artandtechspace/Smart-Arrow/Arrows stl data/Stütze Kanal v1.stl

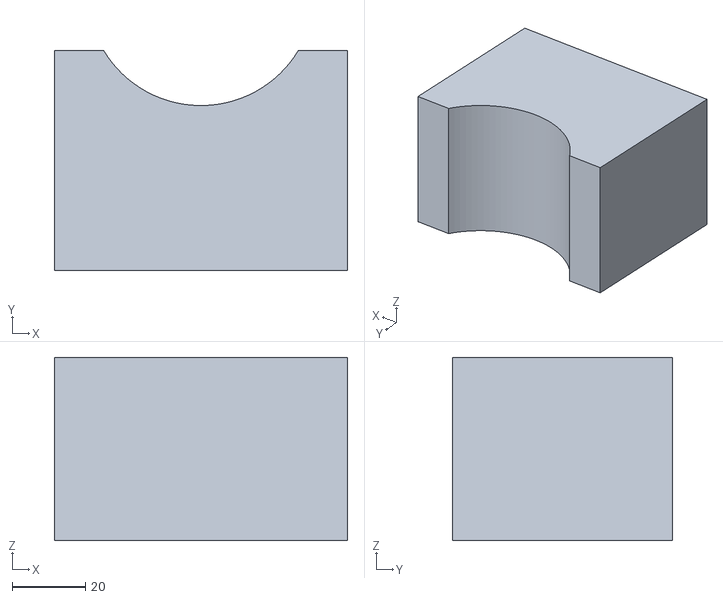
[picture p3: CAD file, 2025-03-22]
Arrows stl data/Stütze Kanal v1.stl
80.0 x 60.0 x 50.0
