artandtechspace/Smart-Arrow/Arrows stl data/Pfeilbauteil mit Wand v2.stl

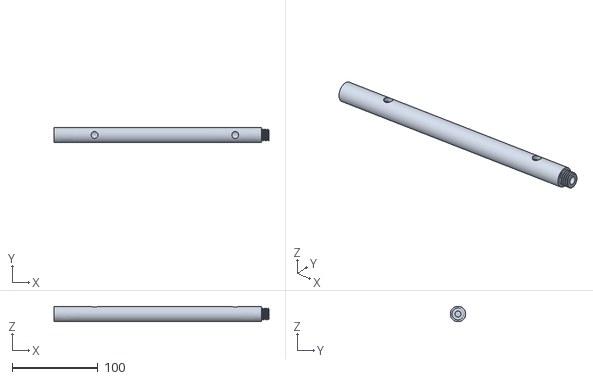
[picture p4: CAD file, 2025-03-22]
Arrows stl data/Pfeilbauteil mit Wand v2.stl
250.0 x 18.0 x 18.0
