artandtechspace/Smart-Arrow/Arrows stl data/Pfeilspitzenhalter v13.stl

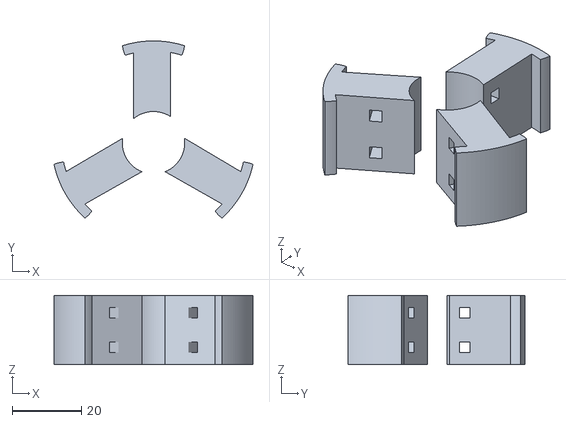
[picture p5: CAD file, 2025-03-22]
Arrows stl data/Pfeilspitzenhalter v13.stl
57.4 x 51.1 x 20.0
