artandtechspace/Smart-Arrow/Arrows stl data/Gewinde.stl

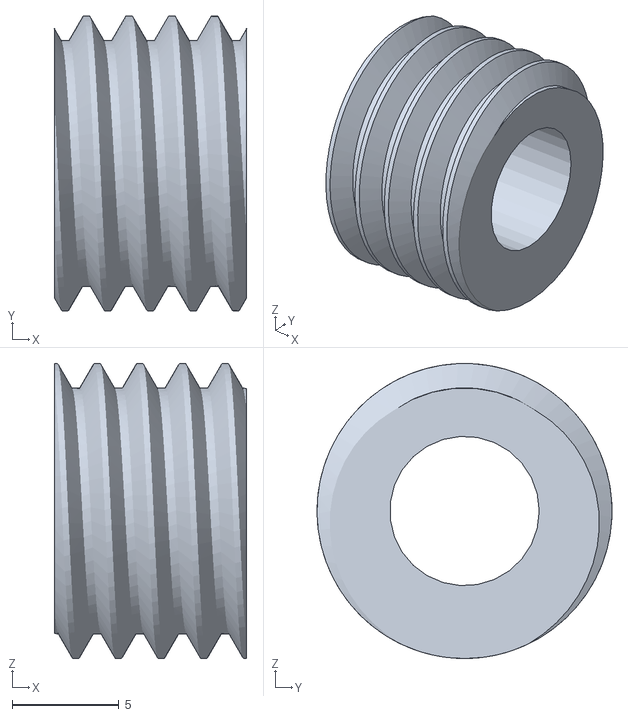
[picture p6: CAD file, 2025-03-06]
Arrows stl data/Gewinde.stl
9.00 x 13.8 x 13.8
