artandtechspace/Smart-Arrow/Arrows stl data/Pfeilspitze 13 mm v7.stl

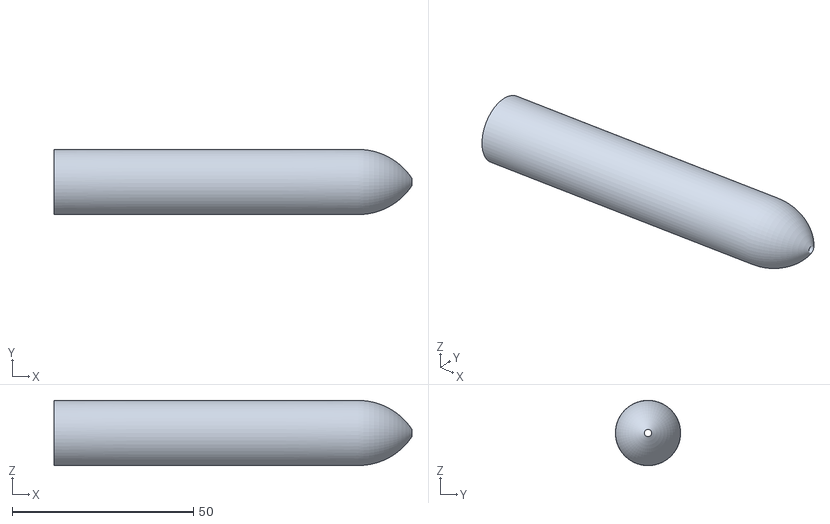
[picture p7: CAD file, 2025-03-06]
Arrows stl data/Pfeilspitze 13 mm v7.stl
98.8 x 18.0 x 18.0
