artandtechspace/Smart-Arrow/Arrows stl data/Pfeilbauteil Querschnitt.stl

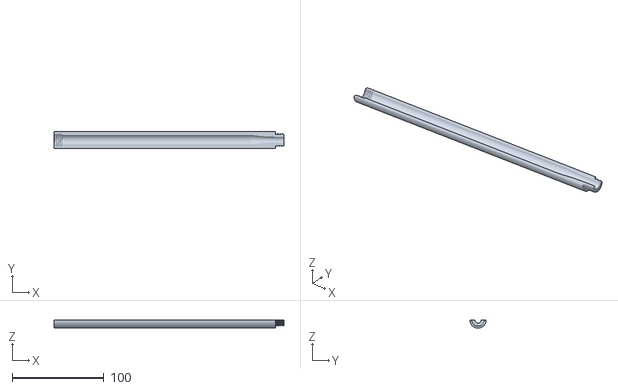
[picture p8: CAD file, 2025-03-06]
Arrows stl data/Pfeilbauteil Querschnitt.stl
250.0 x 18.0 x 9.00
