artandtechspace/Smart-Arrow/Arrows stl data/Pfeilspitzenhalter v12.stl

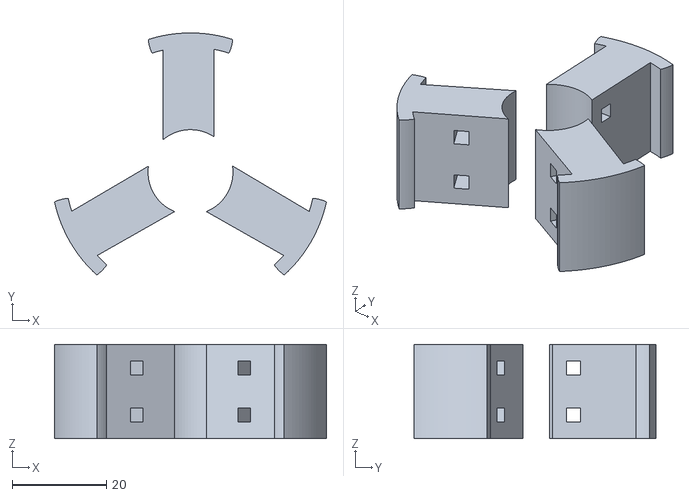
[picture p9: CAD file, 2025-03-22, an earlier design]
Arrows stl data/Pfeilspitzenhalter v12.stl
57.6 x 51.3 x 20.0
