artandtechspace/Smart-Arrow/Arrows stl data/Pfeilbauteil mit Wand v1.stl

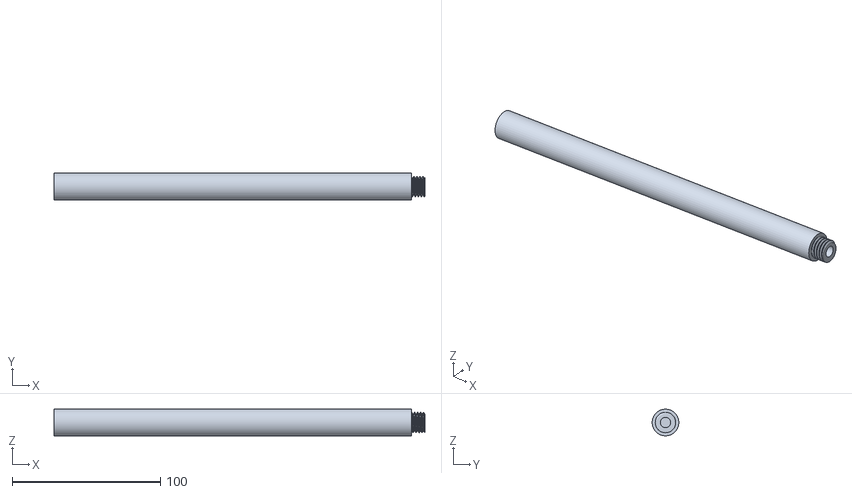
[picture p10: CAD file, 2025-03-22, an earlier design]
Arrows stl data/Pfeilbauteil mit Wand v1.stl
250.0 x 18.0 x 17.9
