artandtechspace/Smart-Arrow/Arrows stl data/Pfeilspitze 13 mm v1.stl

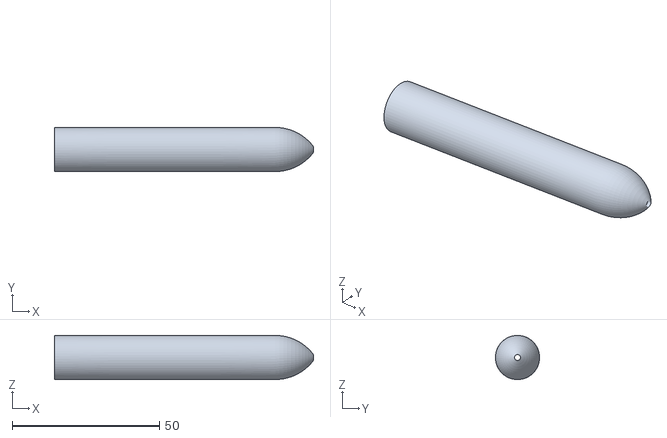
[picture p11: CAD file, 2025-03-06, an earlier design]
Arrows stl data/Pfeilspitze 13 mm v1.stl
88.0 x 15.0 x 15.0
