artandtechspace/Smart-Arrow/Arrows stl data/Pfeilbauteil v1.stl

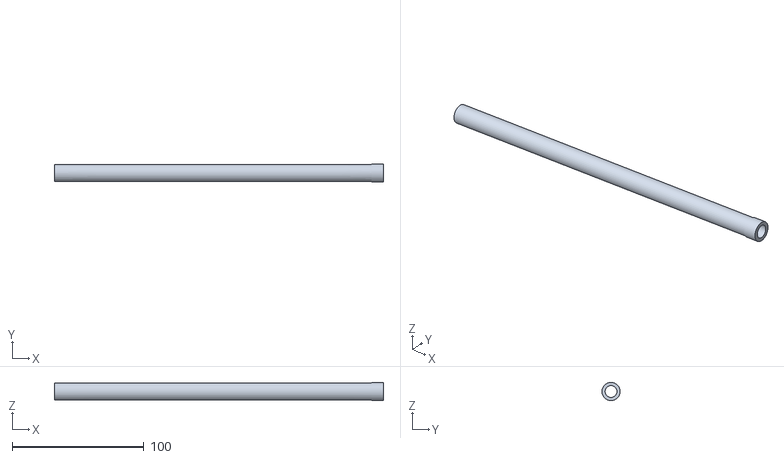
[picture p12: CAD file, 2025-03-06, an earlier design]
Arrows stl data/Pfeilbauteil v1.stl
250.0 x 13.8 x 13.8
