artandtechspace/Smart-Arrow/Arrows stl data/Pfeilspitze 13 mm v6.stl

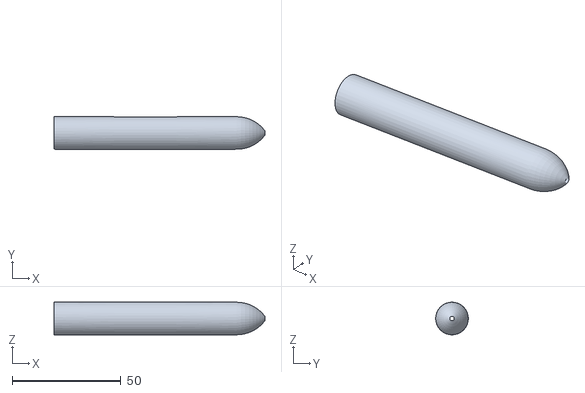
[picture p13: CAD file, 2025-03-06, an earlier design]
Arrows stl data/Pfeilspitze 13 mm v6.stl
97.0 x 15.0 x 15.0
