artandtechspace/Smart-Arrow/Arrows stl data/Pfeilspitzenhalter v2.stl

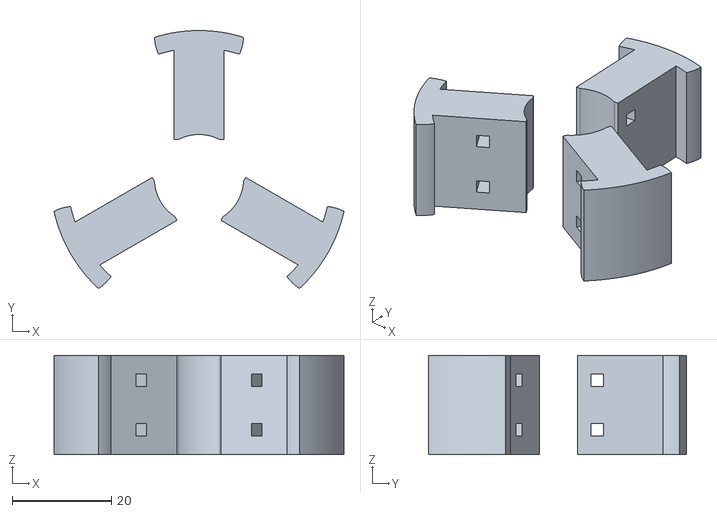
[picture p14: CAD file, 2025-03-06, an earlier design]
Arrows stl data/Pfeilspitzenhalter v2.stl
58.6 x 52.1 x 20.0
