artandtechspace/Smart-Arrow/Arrows stl data/Pfeilspitzenhalter v1.stl

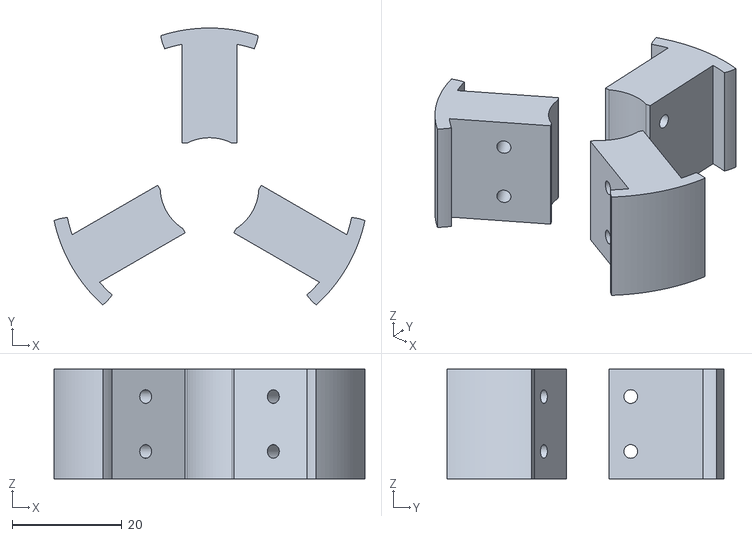
[picture p15: CAD file, 2025-03-06, an earlier design]
Arrows stl data/Pfeilspitzenhalter v1.stl
56.7 x 50.5 x 20.0
