artandtechspace/Smart-Arrow/Arrows stl data/Pfeilspitzenhalter v9.stl

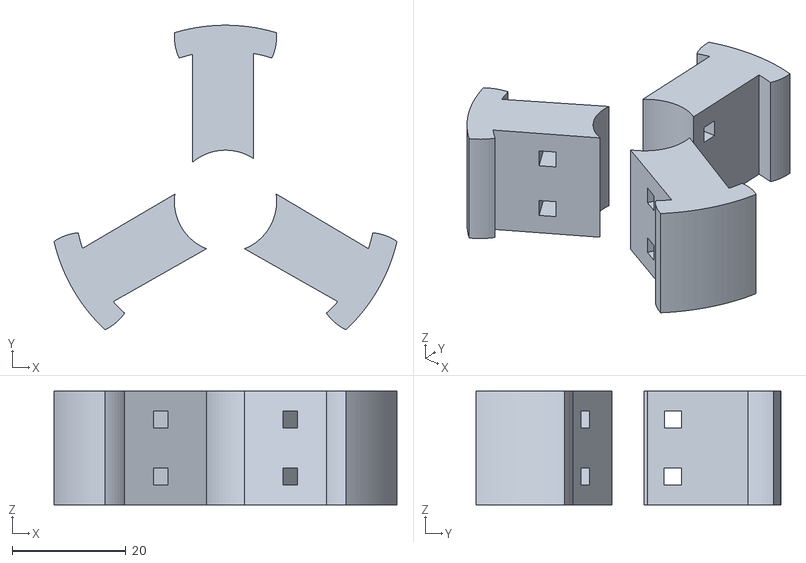
[picture p16: CAD file, 2025-03-06, an earlier design]
Arrows stl data/Pfeilspitzenhalter v9.stl
60.4 x 53.6 x 20.0
