artandtechspace/Smart-Arrow/Arrows stl data/Pfeilspitze 13 mm v3.stl

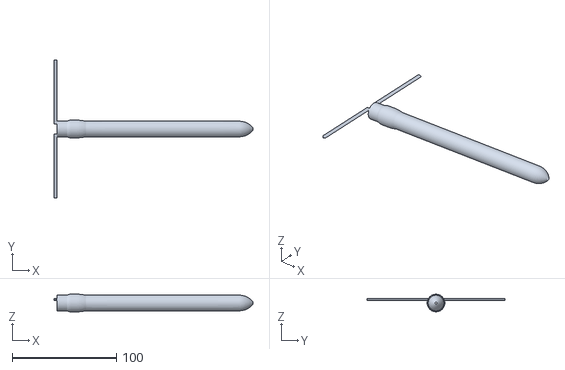
[picture p17: CAD file, 2025-03-06, an earlier design]
Arrows stl data/Pfeilspitze 13 mm v3.stl
191.0 x 132.0 x 17.0
