artandtechspace/Smart-Arrow/Arrows stl data/Pfeilspitzenhalter v10.stl

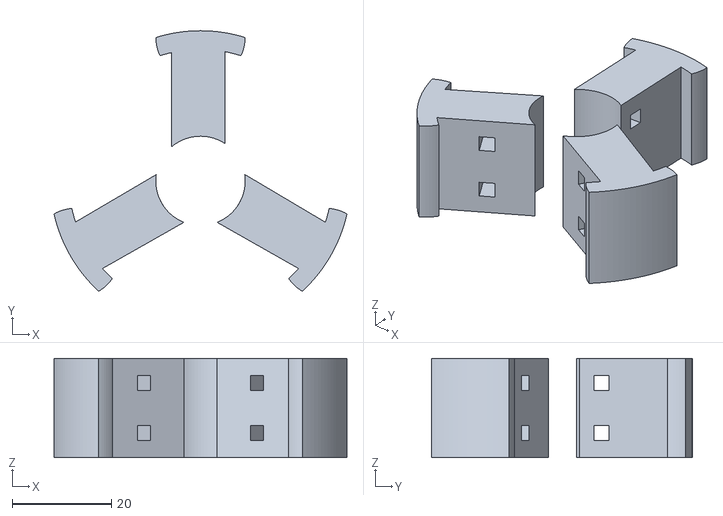
[picture p18: CAD file, 2025-03-06, an earlier design]
Arrows stl data/Pfeilspitzenhalter v10.stl
59.0 x 52.5 x 20.0
