artandtechspace/Smart-Arrow/(list of files, cad)

Other CAD files:
Arrows stl data/Pfeilbauteil v5.stl
Arrows stl data/Pfeilbauteil v4.stl
Arrows stl data/Pfeilbauteil v2.stl
Arrows stl data/Pfeilbauteil v3.stl
Arrows stl data/Pfeilspitze 13 mm v2.stl
Arrows stl data/Pfeilspitze 13 mm v5.stl
Arrows stl data/Pfeilspitzenhalter v11.stl
Arrows stl data/Pfeilspitzenhalter v3.stl
Arrows stl data/Pfeilspitzenhalter v4.stl
Arrows stl data/Pfeilspitzenhalter v5.stl
Arrows stl data/Pfeilspitzenhalter v7.stl
Arrows stl data/Pfeilspitzenhalter v8.stl
