artandtechspace/Smart-Arrow/Hardware/Pfeil.kicad_pcb

## KiCad design Hardware/Pfeil.kicad_pcb (2025-03-22)

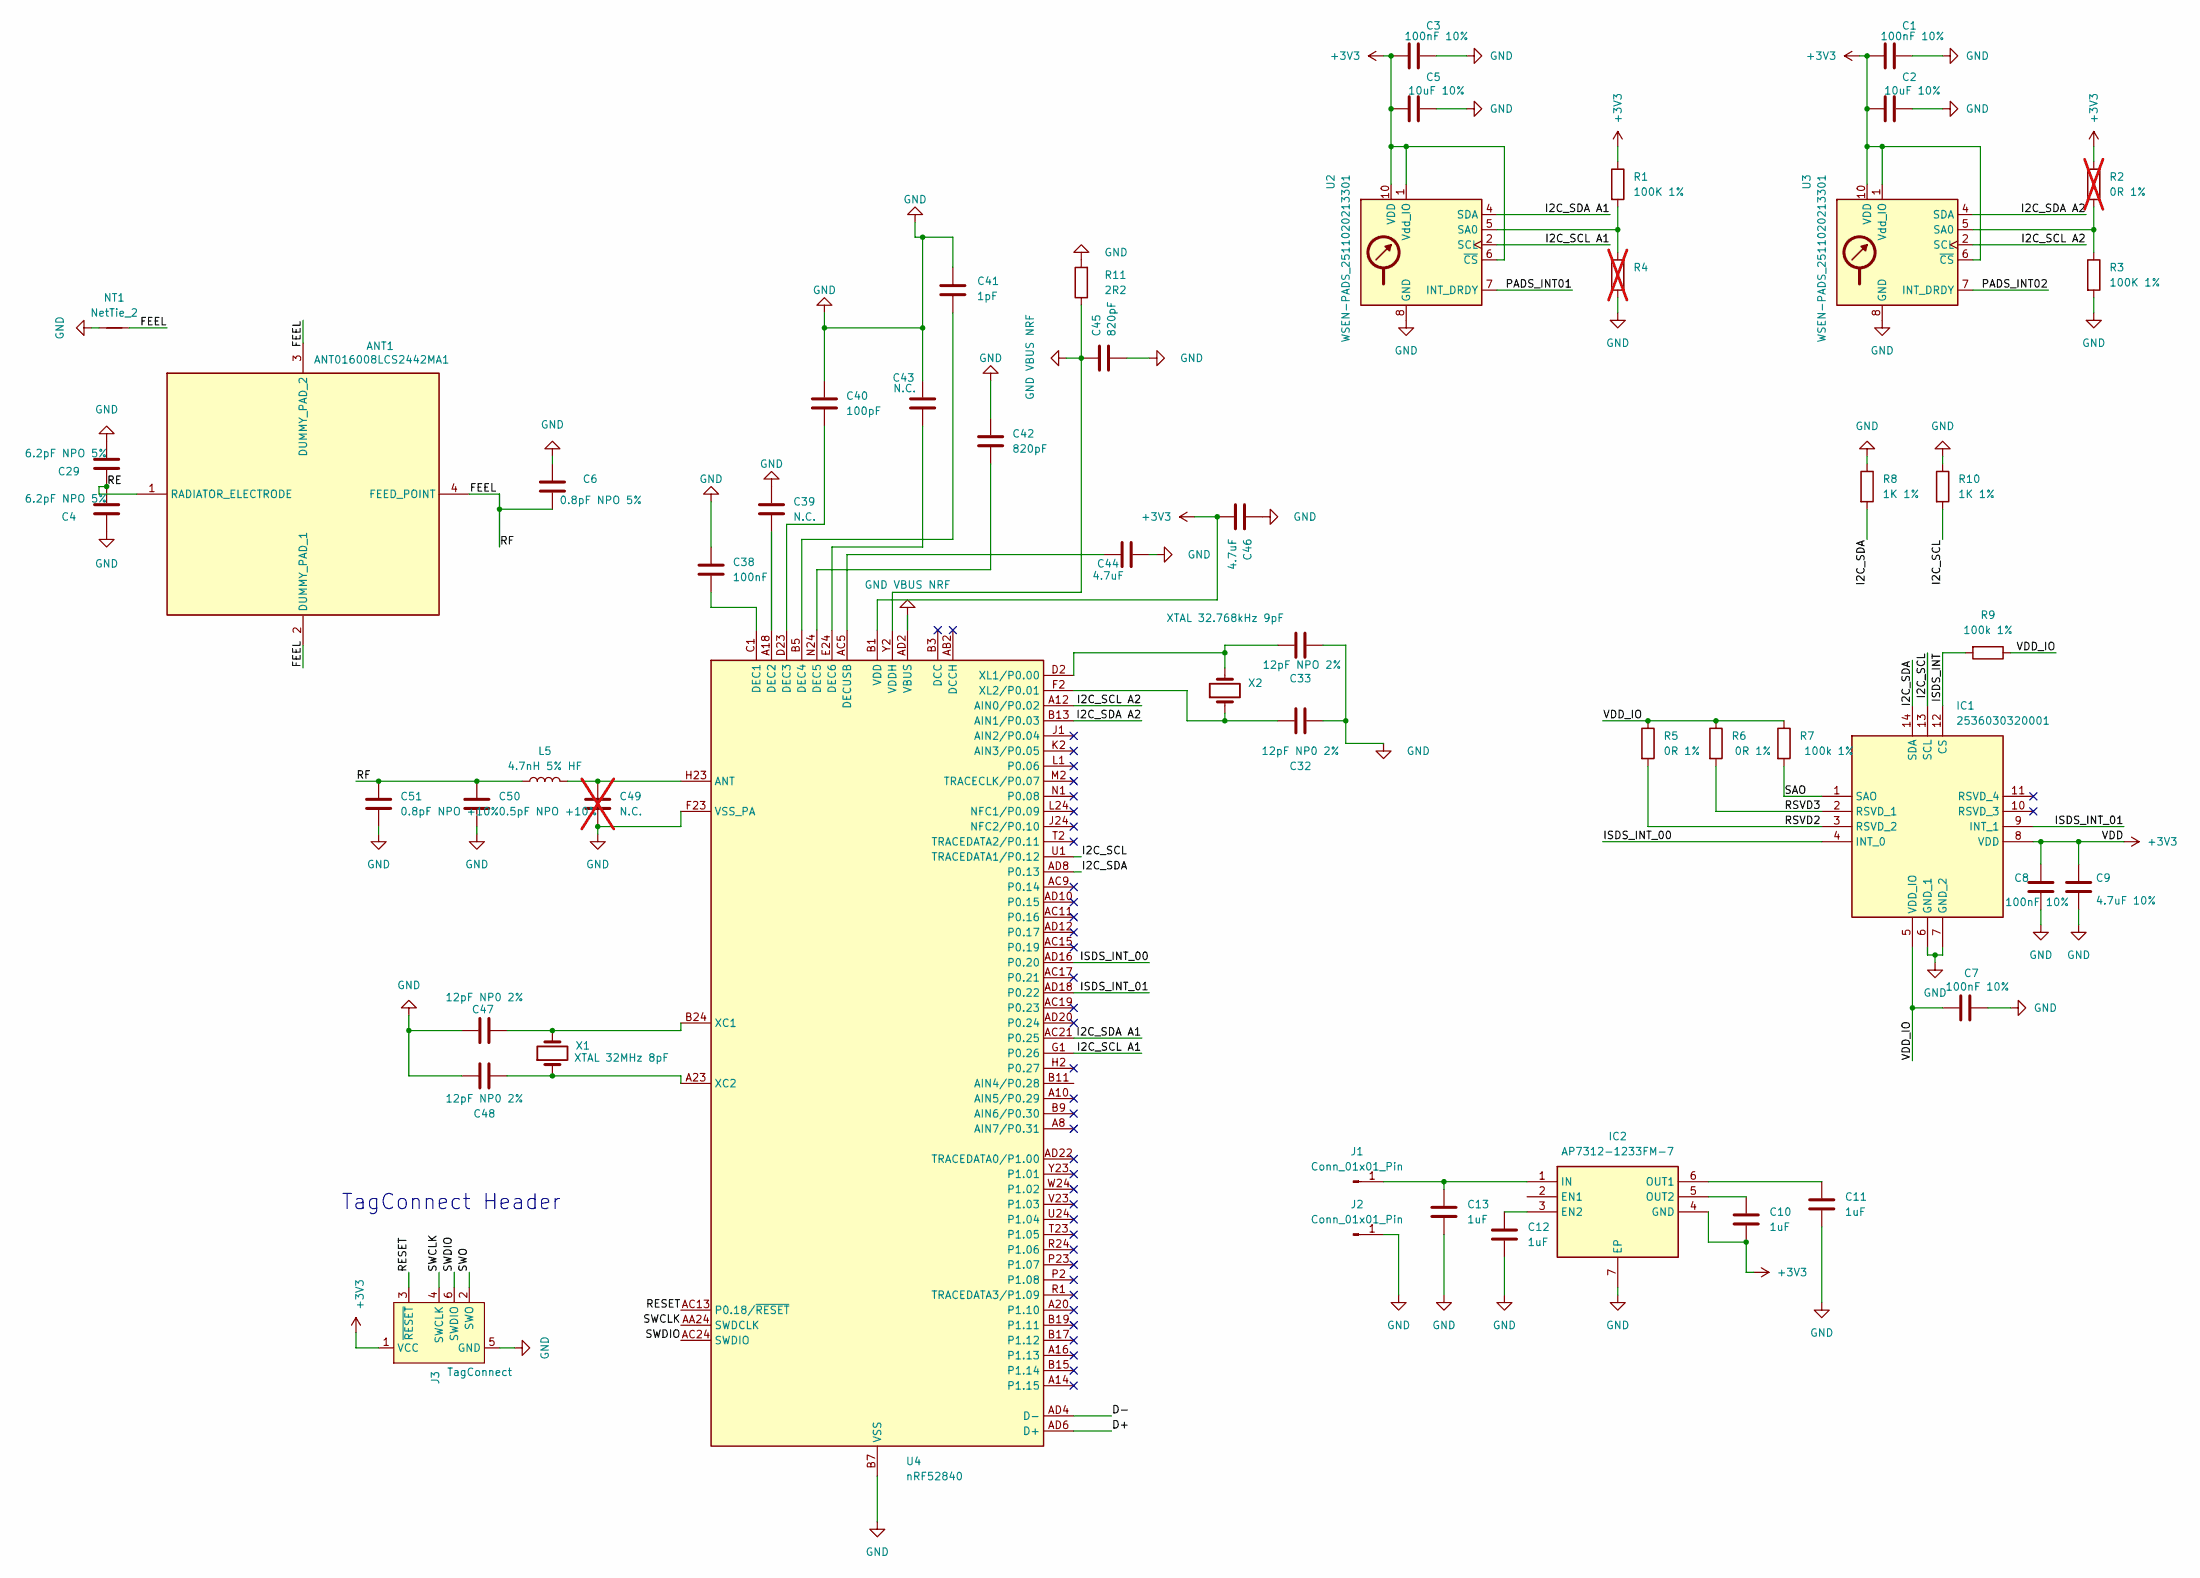
[picture p19: schematic Pfeil.kicad_sch]

Parts:
ANT1: ANT016008LCS2442MA1; Mouser Part Number 810-ANT168LCS2442MA1
C1, C3, C7, C8: 100nF 10%; C_0201_0603Metric
C2, C5: 10uF 10%; C_0402_1005Metric
C4, C29: 6.2pF NPO 5%; C_0201_0603Metric
C6: 0.8pF NPO 5%; C_0201_0603Metric
C9: 4.7uF 10%; C_0201_0603Metric
C10, C11, C12, C13: 1uF; C_0805_2012Metric
C32, C47, C48: 12pF NP0 2%; C_0201_0603Metric
C33: 12pF NPO 2%; C_0201_0603Metric
C38: 100nF; C_0201_0603Metric
C39, C43: N.C.; C_0201_0603Metric
C40: 100pF; C_0201_0603Metric
C41: 1pF; C_0201_0603Metric
C42, C45: 820pF; C_0201_0603Metric
C44, C46: 4.7uF; C_0201_0603Metric
C49: N.C.; C_0201_0603Metric; not fitted
C50: 0.5pF NPO +10%; C_0201_0603Metric
C51: 0.8pF NPO +10%; C_0201_0603Metric
IC1: 2536030320001; Mouser Part Number 710-2536030320001
IC2: AP7312-1233FM-7; SON50P201X181X60-7N; Mouser Part Number 621-AP7312-1233FM-7
J1, J2: Conn_01x01_Pin; SolderWirePad_1x01_SMD_1x2mm
J3: TagConnect; Tag-Connect_TC2030-IDC-NL_2x03_P1.27mm_Vertical
L5: 4.7nH 5% HF; LED_0402_1005Metric
NT1: NetTie_2; NetTie-2_SMD_Pad0.5mm
R1, R3: 100K 1%; R_0201_0603Metric
R2: 0R 1%; R_0201_0603Metric; not fitted
R4: R_0201_0603Metric; not fitted
R5, R6: 0R 1%; R_0201_0603Metric
R7, R9: 100k 1%; R_0201_0603Metric
R8, R10: 1K 1%; R_0201_0603Metric
R11: 2R2; R_0201_0603Metric
U2, U3: WSEN-PADS_2511020213301; ST_HLGA-10_2x2mm_P0.5mm_LayoutBorder3x2y
U4: nRF52840; Nordic_AQFN-73-1EP_7x7mm_P0.5mm
X1: XTAL 32MHz 8pF; Crystal_SMD_2016-4Pin_2.0x1.6mm
X2: XTAL 32.768kHz 9pF; Crystal_SMD_2016-4Pin_2.0x1.6mm

Connections:
+3V3: C1.1, C2.1, C3.1, C5.1, C8.1, C9.1, C10.2, C46.2, IC1.8 (VDD), IC2.4 (GND), J3.1 (VCC), R1.1, R2.1, U2.1 (Vdd_IO), U2.6 (~CS), U2.10 (VDD), U3.1 (Vdd_IO), U3.6 (~CS), U3.10 (VDD), U4.A22 (VDD), U4.AD14 (VDD), U4.AD23 (VDD), U4.B1 (VDD), U4.W1 (VDD)
/D+: U4.AD6 (D+)
/D-: U4.AD4 (D-)
/FEEL: ANT1.2 (DUMMY_PAD_1), ANT1.3 (DUMMY_PAD_2), ANT1.4 (FEED_POINT), C6.2, C50.1, C51.1, L5.1, NT1.2
/I2C_SCL: IC1.13 (SCL), R10.2, U4.U1 (TRACEDATA1/P0.12)
/I2C_SCL A1: U2.2 (SCL), U4.G1 (P0.26)
/I2C_SCL A2: U3.2 (SCL), U4.A12 (AIN0/P0.02)
/I2C_SDA: IC1.14 (SDA), R8.2, U4.AD8 (P0.13)
/I2C_SDA A1: U2.4 (SDA), U4.AC21 (P0.25)
/I2C_SDA A2: U3.4 (SDA), U4.B13 (AIN1/P0.03)
/ISDS_INT: IC1.12 (CS), R9.2
/ISDS_INT_00: IC1.4 (INT_0), U4.AD16 (P0.20)
/ISDS_INT_01: IC1.9 (INT_1), U4.AD18 (P0.22)
/PADS_INT01: U2.7 (INT_DRDY)
/PADS_INT02: U3.7 (INT_DRDY)
/RE: ANT1.1 (RADIATOR_ELECTRODE), C4.2, C29.1
/RESET: J3.3 (~RESET), U4.AC13 (P0.18/~RESET)
/RSVD2: IC1.3 (RSVD_2), R5.2
/RSVD3: IC1.2 (RSVD_1), R6.2
/SAO: IC1.1 (SAO), R7.2
/SWCLK: J3.4 (SWCLK), U4.AA24 (SWDCLK)
/SWDIO: J3.6 (SWDIO), U4.AC24 (SWDIO)
/SWO: J3.2 (SWO)
/VDD_IO: C7.1, IC1.5 (VDD_IO), R5.1, R6.1, R7.1, R9.1
GND: C1.2, C2.2, C3.2, C4.1, C5.2, C6.1, C7.2, C8.2, C9.2, C11.2, C12.2, C13.2, C29.2, C32.2, C33.1, C38.1, C39.1, C40.1, C41.1, C42.1, C43.2, C44.1, C45.2, C46.1, C47.2, C48.2, C49.2, C50.2, C51.2, IC1.6 (GND_1), IC1.7 (GND_2), IC2.7 (EP), J2.1, J3.5 (GND), NT1.1, R3.2, R4.2, R8.1, R10.1, R11.2, U2.3 (GND), U2.8 (GND), U2.9 (GND), U3.3 (GND), U3.8 (GND), U3.9 (GND), U4.B7 (VSS), U4.EP (VSS), U4.F23 (VSS_PA)
GND VBUS NRF: C45.1, R11.1, U4.AD2 (VBUS), U4.Y2 (VDDH)
unnamed: C12.1, IC2.3 (EN2)
unnamed: C13.1, IC2.1 (IN), J1.1
unnamed: C11.1, IC2.6 (OUT1)
unnamed: C10.1, IC2.5 (OUT2)
unnamed: R1.2, R4.1, U2.5 (SA0)
unnamed: R2.2, R3.1, U3.5 (SA0)
unnamed: C49.1, L5.2, U4.H23 (ANT)
unnamed: C38.2, U4.C1 (DEC1)
unnamed: C39.2, U4.A18 (DEC2)
unnamed: C40.2, U4.D23 (DEC3)
unnamed: C41.2, U4.B5 (DEC4)
unnamed: C42.2, U4.N24 (DEC5)
unnamed: C43.1, U4.E24 (DEC6)
unnamed: C44.2, U4.AC5 (DECUSB)
unnamed: C47.1, U4.B24 (XC1), X1.2
unnamed: C48.1, U4.A23 (XC2), X1.1
unnamed: C33.2, U4.D2 (XL1/P0.00), X2.2
unnamed: C32.1, U4.F2 (XL2/P0.01), X2.1

Notes on the sheet:
TagConnect Header

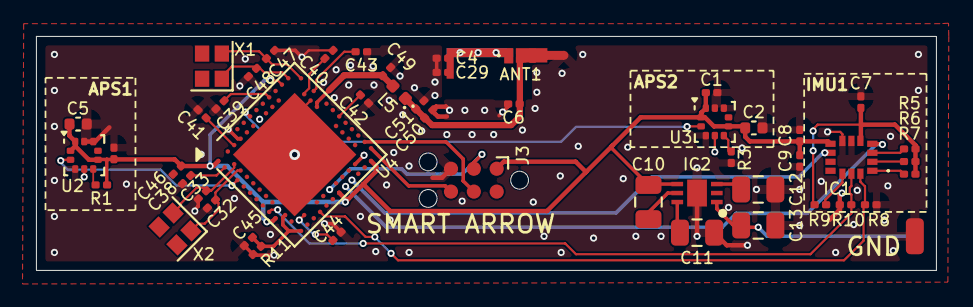
[picture p20: board Pfeil.kicad_pcb from above]

Board: 4 copper layers, 50.0 x 13.0 mm, 52 parts (1 on the bottom side), 39 nets.
