artandtechspace/Smart-Arrow/(commit log)

2024-12-20 File Upload
    [6ac.kicad_sch, Pfeil.kicad_pcb, Pfeil.kicad_sch]
2025-01-07 continued pcb routing
    [6ac.kicad_sch, Pfeil.kicad_pcb, Pfeil.kicad_sch]
2025-01-08 table of content for Jufo 2025
    [Pfeilspitze v2.stl, Pfeilspitze v3 6,8 mm d.stl, pfeilspitze v1.stl]
2025-01-08 stl datas for the arrowhead
    [Pfeilspitze v2.stl, Pfeilspitze v3 6,8 mm d.stl, pfeilspitze v1.stl]
2025-01-17 Create Struktur der schriftlichen Arbeit Kopie.pdf
2025-01-25 error correction
    [Pfeil.kicad_pcb]
2025-02-08 larger pcb
    [Pfeilspitze v2.stl, Pfeilspitze v3 6,8 mm d.stl, pfeilspitze v1.stl]
2025-02-08 Fix some shit
    [Pfeil.kicad_pcb, Pfeil.kicad_sch]
2025-02-09 reroute all
    [Pfeil.kicad_pcb, Pfeil.kicad_sch]
2025-02-09 Auf Süüüüüß Puschen
    [Pfeil.kicad_pcb, Pfeil.kicad_sch]
2025-02-11 fixing and routing
    [Pfeil.kicad_pcb, Pfeil.kicad_sch]
2025-02-11 new gnd for ant
    [Pfeil.kicad_pcb]
2025-02-13 new microcontroller ( other package in libs)
    [Pfeil-B_Mask.gbs, Pfeil-B_Paste.gbp, Pfeil-B_Silkscreen.gbo, Pfeil-Back.gbl, Pfeil-Edge_Cuts.gm1, Pfeil-F_Mask.gts, Pfeil-F_Paste.gtp, Pfeil-F_Silkscreen.gto]
2025-02-14 nrf 52840 changing of the package
    [Pfeil.kicad_pcb, Pfeil.kicad_sch]
2025-02-14 bigger pcb and no more npm1300
    [Pfeil.kicad_pcb, Pfeil.kicad_sch]
2025-02-15 start ing to routing with the new pcb
    [Pfeil.kicad_pcb, Pfeil.kicad_sch]
2025-02-16 Routing and evry component is on the front
    [Pfeil.kicad_pcb, Pfeil.kicad_sch]
2025-02-18 Luca Berthold review
    [Pfeil.kicad_pcb, Pfeil.kicad_sch]
2025-02-18 Fix all sikscreen erros
    [Pfeil.kicad_pcb]
2025-02-19 Bestellte version
    [Pfeil.kicad_pcb, Pfeil.kicad_sch, bom.csv, designators.csv, positions.csv]
2025-02-20 change via size
    [Pfeil.kicad_pcb]
2025-02-22 update last
    [Pfeil.kicad_pcb, Pfeil.kicad_sch]
2025-03-06 stl data
    [Gewinde.stl, Pfeilbauteil Querschnitt.stl, Pfeilbauteil v1.stl, Pfeilbauteil v2.stl, Pfeilbauteil v3.stl, Pfeilbauteil v4.stl, Pfeilbauteil v5.stl, Pfeilspitze 13 mm v1.stl]
